niektb/I2S-SPDIF_Transmitter/uhat_spdif_transmitter/uhat_spdif_transmitter/spdif_transmitter_box v2_lid.3mf

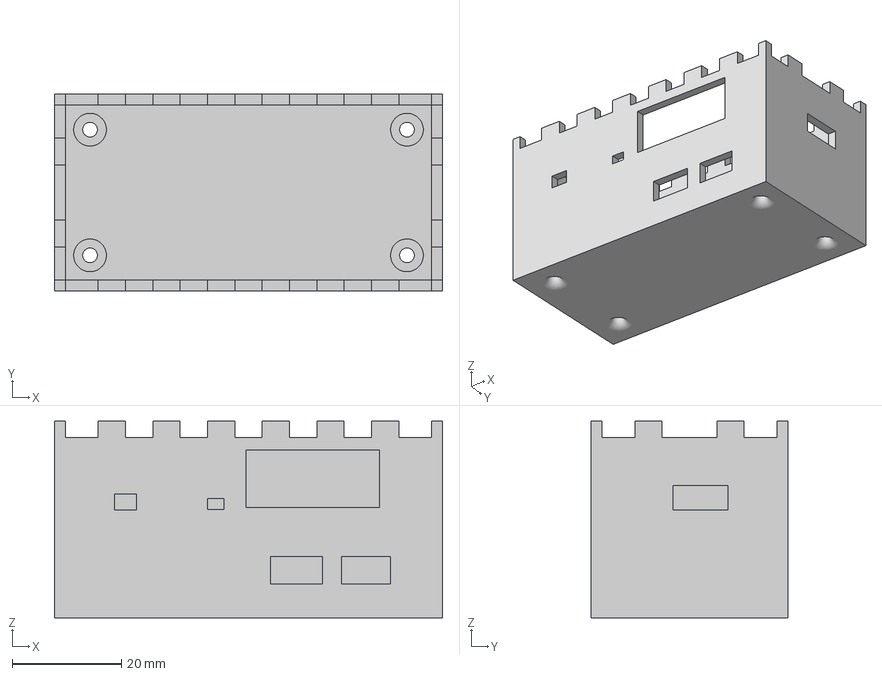
[picture p3: CAD file, 2025-08-05]
uhat_spdif_transmitter/uhat_spdif_transmitter/spdif_transmitter_box v2_lid.3mf
71.0 x 36.0 x 36.0 mm
