niektb/I2S-SPDIF_Transmitter/uhat_spdif_transmitter/uhat_spdif_transmitter/spdif_transmitter_box v2.3mf

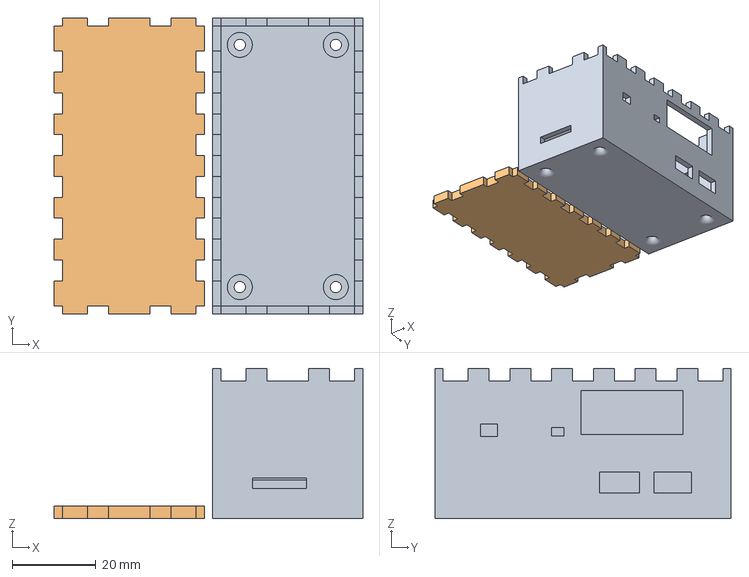
[picture p4: CAD file, 2025-08-05, an earlier design]
uhat_spdif_transmitter/uhat_spdif_transmitter/spdif_transmitter_box v2.3mf
74.0 x 71.0 x 36.0 mm
