niektb/I2S-SPDIF_Transmitter/uhat_spdif_transmitter/uhat_spdif_transmitter/uhat_spdif_transmitter.kicad_pcb

## KiCad design uhat_spdif_transmitter/uhat_spdif_transmitter/uhat_spdif_transmitter.kicad_pcb (2025-07-09)

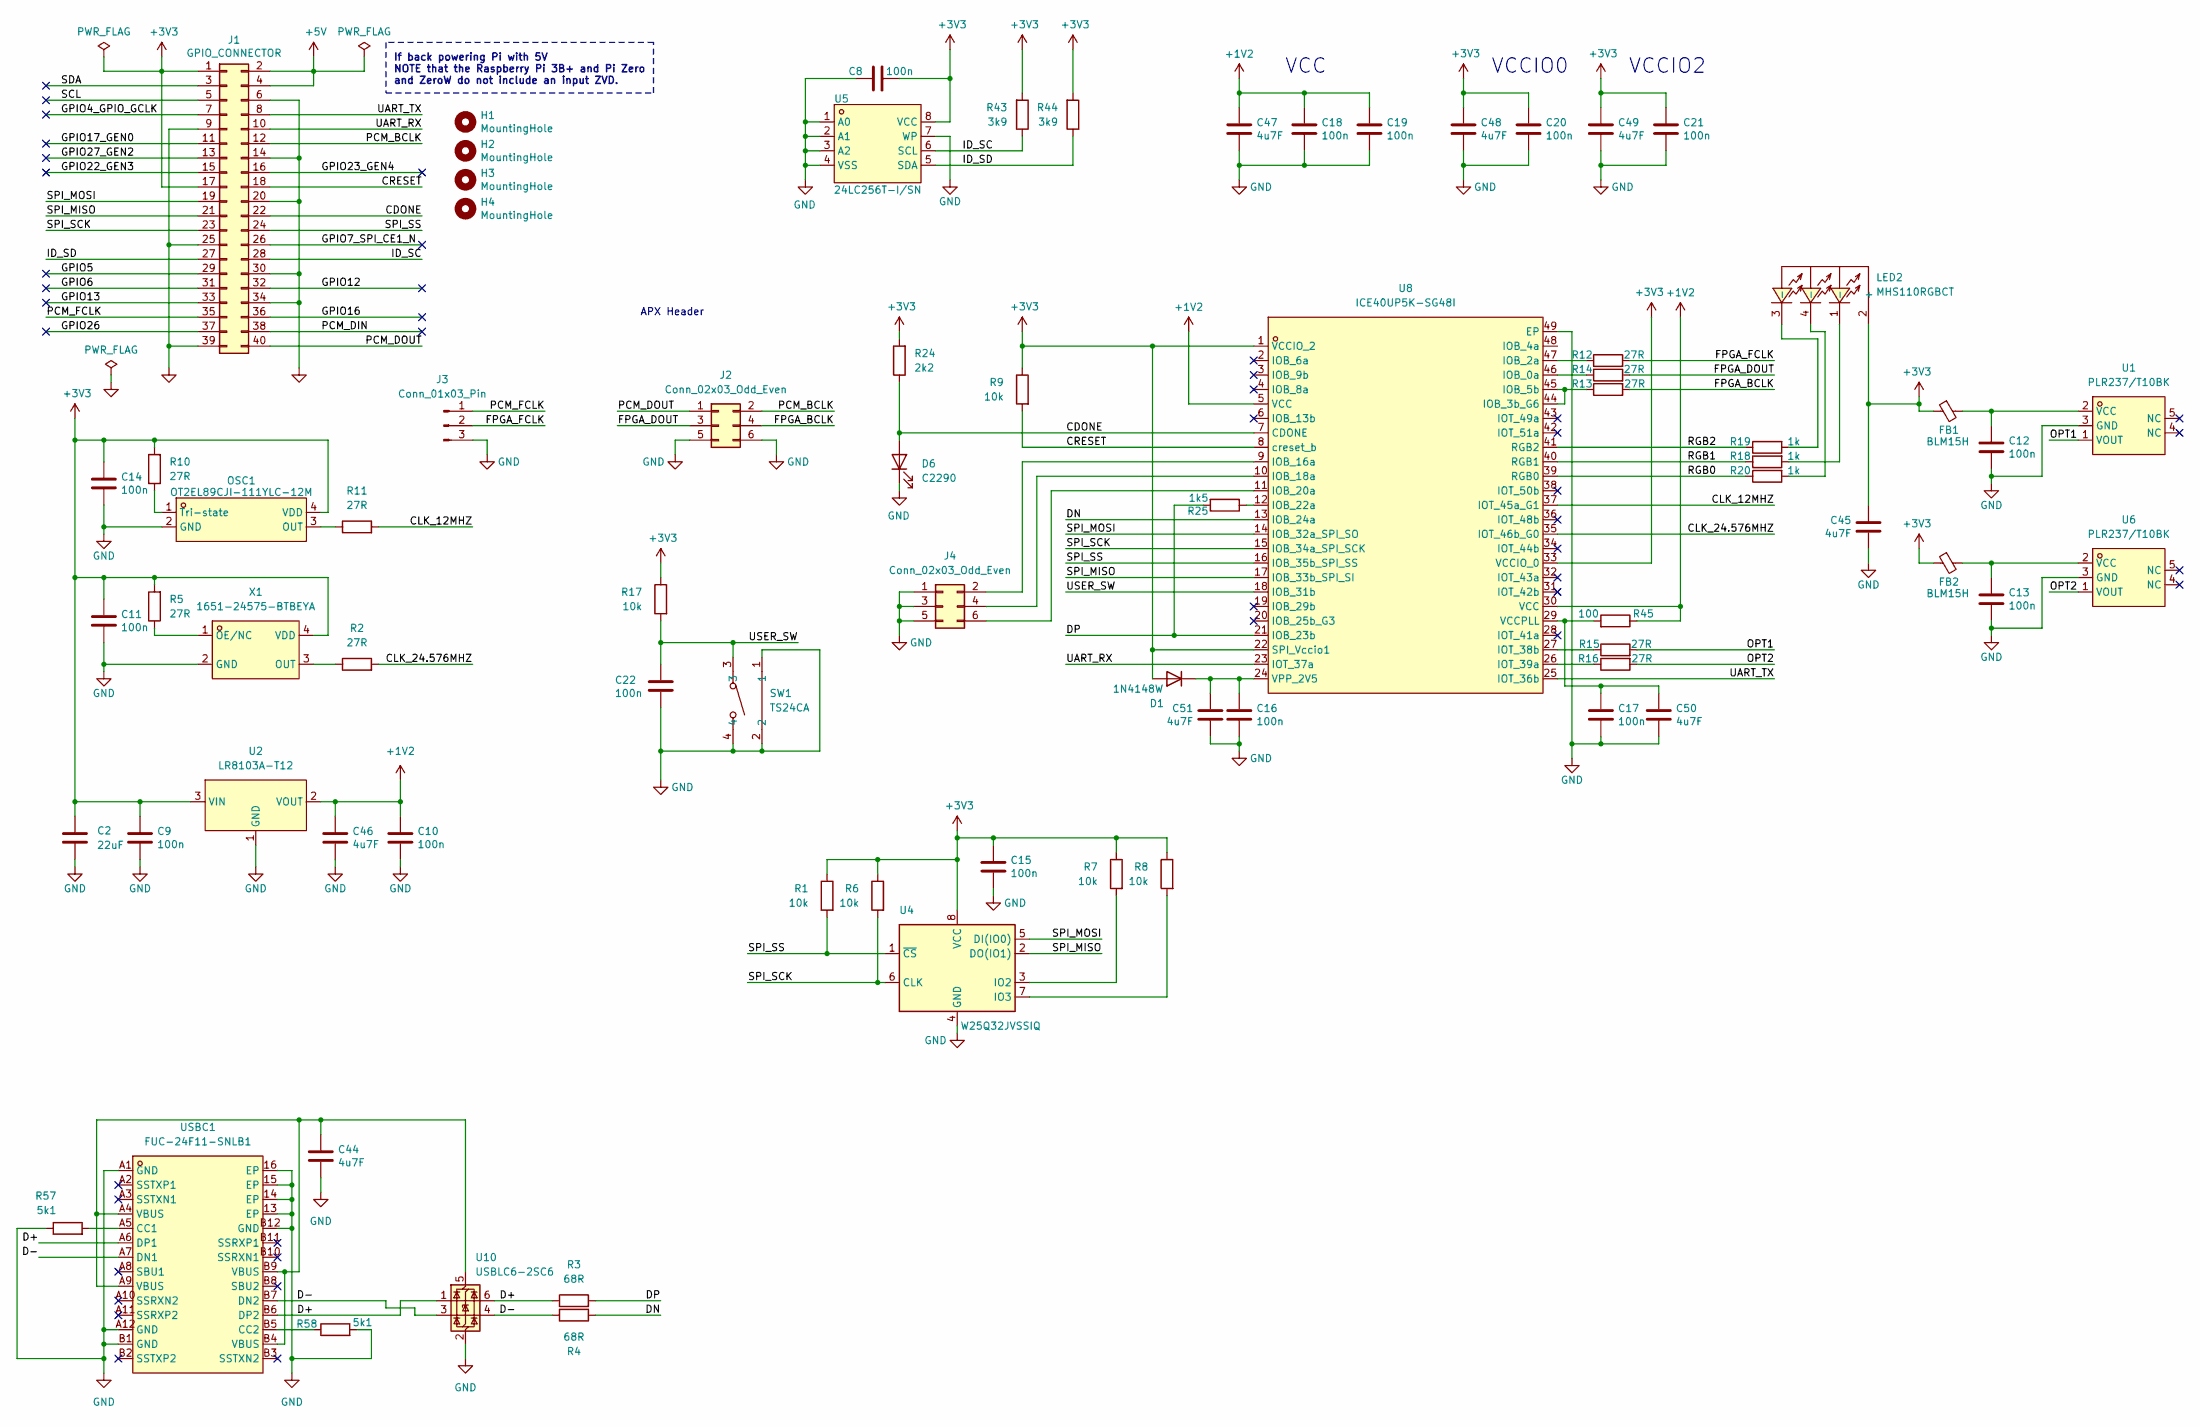
[picture p5: schematic uhat_spdif_transmitter.kicad_sch, Pi Zero W Hat AK4118 SPDIF transmitter]

Parts:
C2: 22uF; C_1206_3216Metric_Pad1.33x1.80mm_HandSolder
C8, C9, C10, C11, C12, C13, C14, C15, C16, C17, C18, C19, C20, C21, C22: 100n; C_0402_1005Metric
C44, C45, C46, C47, C48, C49, C50, C51: 4u7F; C_0603_1608Metric_Pad1.08x0.95mm_HandSolder
D1: 1N4148W; D_SOD-123
D6: C2290; LED_0805_2012Metric
FB1, FB2: BLM15H; L_0402_1005Metric
H1, H2, H3, H4: MountingHole; MountingHole_2.7mm_M2.5_uHAT_RPi
J1: GPIO_CONNECTOR; PinSocket_2x20_P2.54mm_Vertical_Centered_Anchor
J2, J4: Conn_02x03_Odd_Even; PinHeader_2x03_P2.54mm_Vertical
J3: Conn_01x03_Pin; PinHeader_1x03_P2.54mm_Vertical
LED2: MHS110RGBCT; LED-ARRAY-SMD_MHS110RGBCT; LCSC Part C389528
OSC1: OT2EL89CJI-111YLC-12M; OSC-SMD_4P-L3.2-W2.5-BL; LCSC Part C5280582
R1, R6, R7, R8, R9, R17: 10k; R_0402_1005Metric
R2, R5, R10, R11, R12, R13, R14, R15, R16: 27R; R_0402_1005Metric_Pad0.72x0.64mm_HandSolder
R3, R4: 68R; R_0402_1005Metric_Pad0.72x0.64mm_HandSolder
R18, R19, R20: 1k; R_0402_1005Metric_Pad0.72x0.64mm_HandSolder
R24: 2k2; R_0603_1608Metric_Pad0.98x0.95mm_HandSolder
R25: 1k5; R_0603_1608Metric_Pad0.98x0.95mm_HandSolder
R43, R44: 3k9; R_0603_1608Metric_Pad0.98x0.95mm_HandSolder
R45: 100; R_0603_1608Metric_Pad0.98x0.95mm_HandSolder
R57, R58: 5k1; R_0603_1608Metric_Pad0.98x0.95mm_HandSolder
SW1: TS24CA; SW-SMD_TS24CA; LCSC Part C393942
U1, U6: PLR237/T10BK; OPTO-TH_PLR237-T10BK; LCSC Part C17427482
U2: LR8103A-T12; SOT-23-3_L2.9-W1.6-P1.90-LS2.8-BR; LCSC Part C7501644
U4: W25Q32JVSSIQ; SOIC-8_5.3x5.3mm_P1.27mm
U5: 24LC256T-I/SN; SOIC-8_L4.9-W3.9-P1.27-LS6.0-BL; LCSC Part C5458
U8: ICE40UP5K-SG48I; QFN-48_L7.0-W7.0-P0.50-TL-EP5.4-1; LCSC Part C2678152
U10: USBLC6-2SC6; SOT-23-6
USBC1: FUC-24F11-SNLB1; USB-C-SMD_C67380; LCSC Part C67380
X1: 1651-24575-BTBEYA; OSC-SMD_4P-L2.5-W2.0-BL; LCSC Part C3003263

Connections:
+1V2: C10.1, C18.1, C19.1, C46.1, C47.1, R45.1, U2.2 (VOUT), U8.5 (VCC), U8.30 (VCC)
+3V3: C2.1, C8.2, C9.1, C11.1, C14.1, C15.1, C20.1, C21.1, C45.1, C48.1, C49.1, D1.2 (A), FB1.1, FB2.1, J1.1, J1.17, LED2.2 (+), OSC1.4 (VDD), R1.1, R5.2, R6.1, R7.1, R8.1, R9.1, R10.2, R17.1, R24.2, R43.2, R44.2, U2.3 (VIN), U4.8 (VCC), U5.8 (VCC), U8.1 (VCCIO_2), U8.22 (SPI_Vccio1), U8.33 (VCCIO_0), X1.4 (VDD)
+5V: J1.2, J1.4
/CDONE: D6.2 (A), J1.22, R24.1, U8.7 (CDONE)
/CLK_12MHZ: R11.2, U8.37 (IOT_45a_G1)
/CLK_24.576MHZ: R2.2, U8.35 (IOT_46b_G0)
/CRESET: J1.18, R9.2, U8.8 (creset_b)
/D+: R3.1, U10.1 (I/O1), U10.6 (I/O1), USBC1.A6 (DP1), USBC1.B6 (DP2)
/D-: R4.1, U10.3 (I/O2), U10.4 (I/O2), USBC1.A7 (DN1), USBC1.B7 (DN2)
/DN: R4.2, U8.13 (IOB_24a)
/DP: R3.2, R25.2, U8.21 (IOB_23b)
/FPGA_BCLK: J2.4, R13.2
/FPGA_DOUT: J2.3, R14.2
/FPGA_FCLK: J3.2, R12.2
/GPIO4_GPIO_GCLK: J1.7
/GPIO5: J1.29
/GPIO6: J1.31
/GPIO7_SPI_CE1_N: J1.26
/GPIO12: J1.32
/GPIO13: J1.33
/GPIO16: J1.36
/GPIO17_GEN0: J1.11
/GPIO22_GEN3: J1.15
/GPIO23_GEN4: J1.16
/GPIO26: J1.37
/GPIO27_GEN2: J1.13
/ID_SC: J1.28, R43.1, U5.6 (SCL)
/ID_SD: J1.27, R44.1, U5.5 (SDA)
/OPT1: R15.2, U1.1 (VOUT)
/OPT2: R16.2, U6.1 (VOUT)
/PCM_BCLK: J1.12, J2.2
/PCM_DIN: J1.38
/PCM_DOUT: J1.40, J2.1
/PCM_FCLK: J1.35, J3.1
/RGB0: R20.1, U8.39 (RGB0)
/RGB1: R18.1, U8.40 (RGB1)
/RGB2: R19.1, U8.41 (RGB2)
/SCL: J1.5
/SDA: J1.3
/SPI_MISO: J1.21, U4.2 (DO(IO1)), U8.17 (IOB_33b_SPI_SI)
/SPI_MOSI: J1.19, U4.5 (DI(IO0)), U8.14 (IOB_32a_SPI_SO)
/SPI_SCK: J1.23, R6.2, U4.6 (CLK), U8.15 (IOB_34a_SPI_SCK)
/SPI_SS: J1.24, R1.2, U4.1 (~CS), U8.16 (IOB_35b_SPI_SS)
/UART_RX: J1.10, U8.23 (IOT_37a)
/UART_TX: J1.8, U8.25 (IOT_36b)
/USER_SW: C22.1, R17.2, SW1.3, U8.18 (IOB_31b)
GND: C2.2, C8.1, C9.2, C10.2, C11.2, C12.2, C13.2, C14.2, C15.2, C16.2, C17.2, C18.2, C19.2, C20.2, C21.2, C22.2, C44.2, C45.2, C46.2, C47.2, C48.2, C49.2, C50.2, C51.2, D6.1 (K), J1.6, J1.9, J1.14, J1.20, J1.25, J1.30, J1.34, J1.39, J2.5, J2.6, J3.3, J4.1, J4.3, J4.5, OSC1.2 (GND), R57.1, R58.2, SW1.1, SW1.2, SW1.4, U1.3 (GND), U2.1 (GND), U4.4 (GND), U5.1 (A0), U5.2 (A1), U5.3 (A2), U5.4 (VSS), U5.7 (WP), U6.3 (GND), U8.49 (EP), U10.2 (GND), USBC1.13 (EP), USBC1.14 (EP), USBC1.15 (EP), USBC1.16 (EP), USBC1.A1 (GND), USBC1.A12 (GND), USBC1.B1 (GND), USBC1.B12 (GND), X1.2 (GND)
unnamed: C16.1, C51.1, D1.1 (K), U8.24 (VPP_2V5)
unnamed: J4.2, U8.9 (IOB_16a)
unnamed: J4.4, U8.10 (IOB_18a)
unnamed: J4.6, U8.11 (IOB_20a)
unnamed: LED2.1 (-), R18.2
unnamed: LED2.3 (-), R19.2
unnamed: LED2.4 (-), R20.2
unnamed: OSC1.3 (OUT), R11.1
unnamed: OSC1.1 (Tri-state), R10.1
unnamed: C12.1, FB1.2, U1.2 (VCC)
unnamed: R7.2, U4.3 (IO2)
unnamed: R8.2, U4.7 (IO3)
unnamed: C13.1, FB2.2, U6.2 (VCC)
unnamed: R14.1, U8.46 (IOB_0a)
unnamed: R12.1, U8.47 (IOB_2a)
unnamed: R13.1, U8.44 (IOB_3b_G6), U8.45 (IOB_5b)
unnamed: R25.1, U8.12 (IOB_22a)
unnamed: R15.1, U8.27 (IOT_38b)
unnamed: R16.1, U8.26 (IOT_39a)
unnamed: C17.1, C50.1, R45.2, U8.29 (VCCPLL)
unnamed: C44.1, U10.5 (VBUS), USBC1.A4 (VBUS), USBC1.A9 (VBUS), USBC1.B4 (VBUS), USBC1.B9 (VBUS)
unnamed: R57.2, USBC1.A5 (CC1)
unnamed: R58.1, USBC1.B5 (CC2)
unnamed: R5.1, X1.1 (OE/NC)
unnamed: R2.1, X1.3 (OUT)

Notes on the sheet:
If back powering Pi with 5V NOTE that the Raspberry Pi 3B+ and Pi Zero and ZeroW do not include an input ZVD.
VCCIO2
APX Header
VCCIO0
VCC

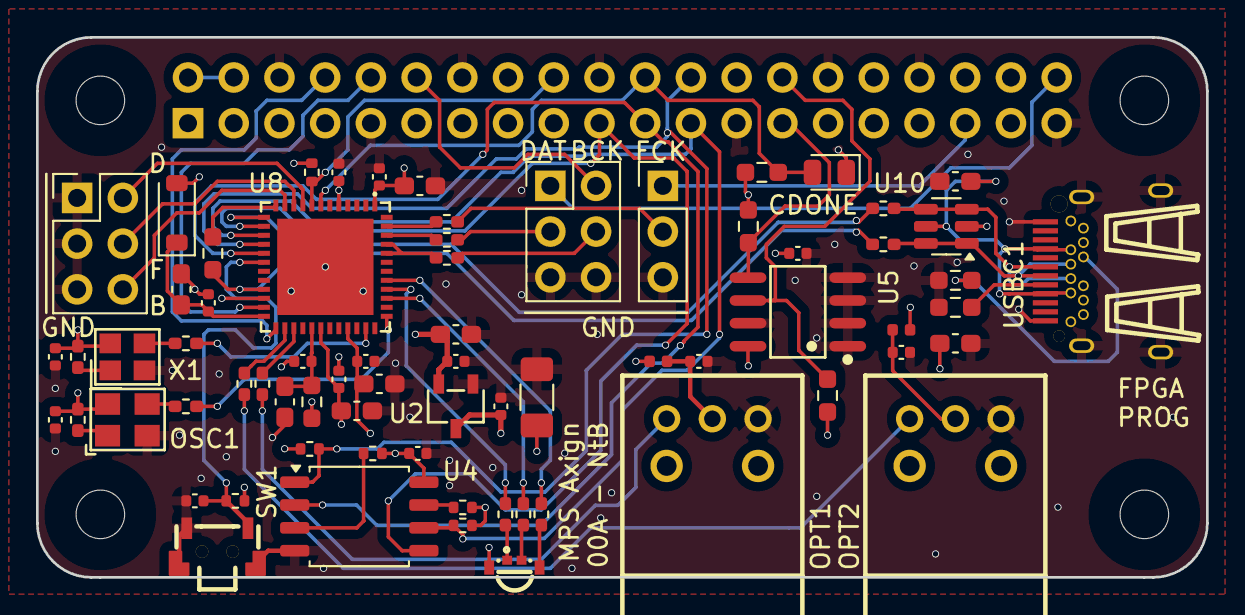
[picture p6: board uhat_spdif_transmitter.kicad_pcb from above]

Board: 4 copper layers, 65.0 x 30.0 mm, 75 parts (1 on the bottom side), 57 nets.
