niektb/I2S-SPDIF_Transmitter/raspberrypi_zerow_uhat/raspberrypi_zerow_uhat.kicad_pcb

## KiCad design raspberrypi_zerow_uhat/raspberrypi_zerow_uhat.kicad_pcb (2025-06-18)

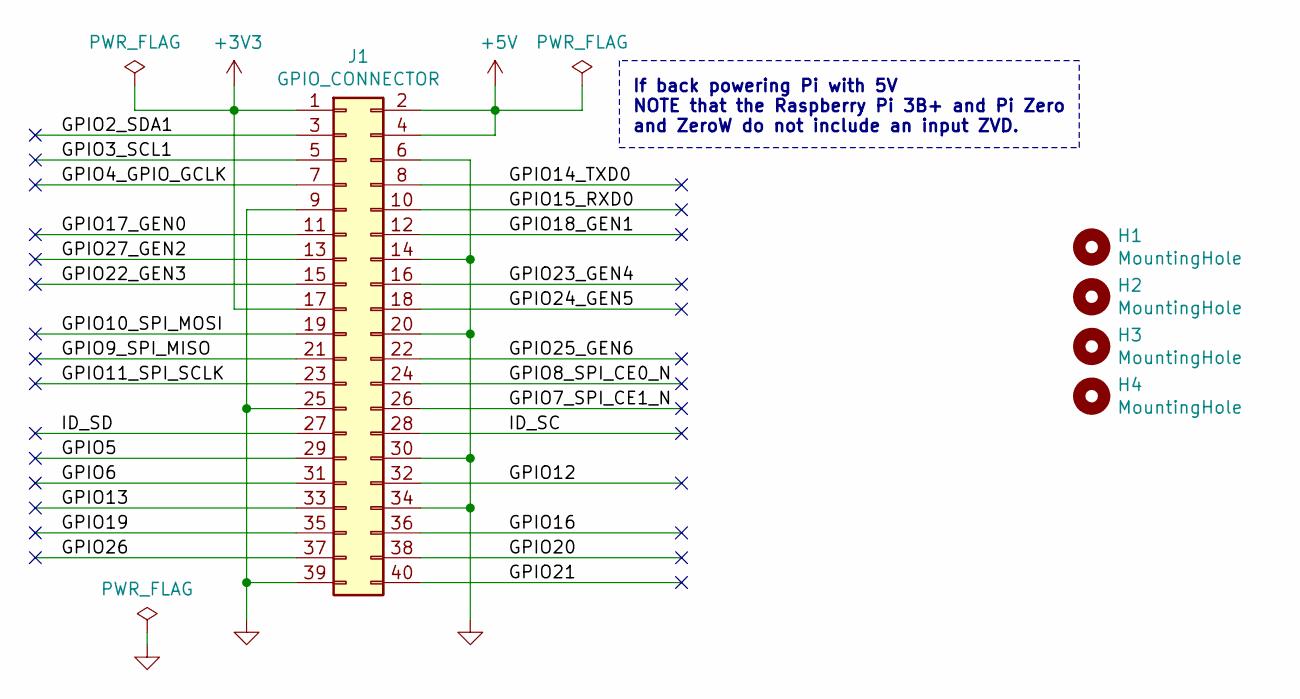
[picture p7: schematic raspberrypi_zerow_uhat.kicad_sch, Pi Zero W Hat AK4118 SPDIF transmitter]

Parts:
H1, H2, H3, H4: MountingHole; MountingHole_2.7mm_M2.5_uHAT_RPi
J1: GPIO_CONNECTOR; PinSocket_2x20_P2.54mm_Vertical_Centered_Anchor

Connections:
+3V3: J1.1, J1.17
+5V: J1.2, J1.4
/GPIO2_SDA1: J1.3
/GPIO3_SCL1: J1.5
/GPIO4_GPIO_GCLK: J1.7
/GPIO5: J1.29
/GPIO6: J1.31
/GPIO7_SPI_CE1_N: J1.26
/GPIO8_SPI_CE0_N: J1.24
/GPIO9_SPI_MISO: J1.21
/GPIO10_SPI_MOSI: J1.19
/GPIO11_SPI_SCLK: J1.23
/GPIO12: J1.32
/GPIO13: J1.33
/GPIO14_TXD0: J1.8
/GPIO15_RXD0: J1.10
/GPIO16: J1.36
/GPIO17_GEN0: J1.11
/GPIO18_GEN1: J1.12
/GPIO19: J1.35
/GPIO20: J1.38
/GPIO21: J1.40
/GPIO22_GEN3: J1.15
/GPIO23_GEN4: J1.16
/GPIO24_GEN5: J1.18
/GPIO25_GEN6: J1.22
/GPIO26: J1.37
/GPIO27_GEN2: J1.13
/ID_SC: J1.28
/ID_SD: J1.27
GND: J1.6, J1.9, J1.14, J1.20, J1.25, J1.30, J1.34, J1.39

Notes on the sheet:
If back powering Pi with 5V NOTE that the Raspberry Pi 3B+ and Pi Zero and ZeroW do not include an input ZVD.

Board: 2 copper layers, 5 parts (1 on the bottom side), 3 nets, no tracks yet.
