niektb/I2S-SPDIF_Transmitter/(commit log)

2025-06-18 update 3d models, component placement
    [uhat_spdif_transmitter.kicad_pcb]
2025-06-21 Finish routing
    [uhat_spdif_transmitter.kicad_pcb, uhat_spdif_transmitter.kicad_sch]
2025-06-23 Finish layouting
    [uhat_spdif_transmitter.kicad_pcb]
2025-06-23 Change push button, add barcode location
    [uhat_spdif_transmitter.kicad_pcb, uhat_spdif_transmitter.kicad_sch]
2025-06-23 Add fabrication files
    [bom.csv, designators.csv, positions.csv, uhat_spdif_transmitter.kicad_pcb]
2025-07-09 Change Optical Connector + other stuff
    [uhat_spdif_transmitter.kicad_pcb, uhat_spdif_transmitter.kicad_sch]
2025-08-05 synthesizable, with bugs ironed out
    [spdif_transmitter_box v2.3mf, spdif_transmitter_box v2_lid.3mf, spdif_transmitter_box v2lod.3mf, spdif_transmitter_box v3.3mf]
2025-08-07 Write to all leds, mirror optical out to I2S Out Data
2025-08-07 Fix bit order, spdif speed
    [fifo.v, i2s_receive1.v, spdif_transmit.v, splitstreamer.v]
2025-08-08 attempt to solve timing issues
    [spdif_transmit.v, splitstreamer.v, splitstreamer_tb.v]
2025-08-08 Fix incorrect pointer wraparound
    [fifo.v, splitstreamer.v, splitstreamer_tb.v]
2025-08-09 Add test for debouncing button
2025-08-28 Improve FCLK monitoring and reset functionality
    [fifo.v, i2s_receive1.v, splitstreamer.v, splitstreamer_tb.v]
2025-08-29 Small fixes to test bench and the way clocks are treated, new build
    [i2s_receive1.v, splitstreamer.v, splitstreamer_tb.v]
2025-08-29 Change LED indicator, change data_en
2025-08-29 Test button
