niektb/I2S-SPDIF_Transmitter/(notices)

Notices in the files:
uhat_spdif_transmitter/uhat_spdif_transmitter/uhat_spdif_transmitter.kicad_pcb:
This PCB design is licensed under MIT Open Source License.
uhat_spdif_transmitter/uhat_spdif_transmitter/uhat_spdif_transmitter.sch:
This Schematic is licensed under MIT Open Source License.
